MKEadmin/Cooling_Cities/Documents/07 Ontwerpen en materiaallijsten/Tekeningen en Schetsen/Hardware.png

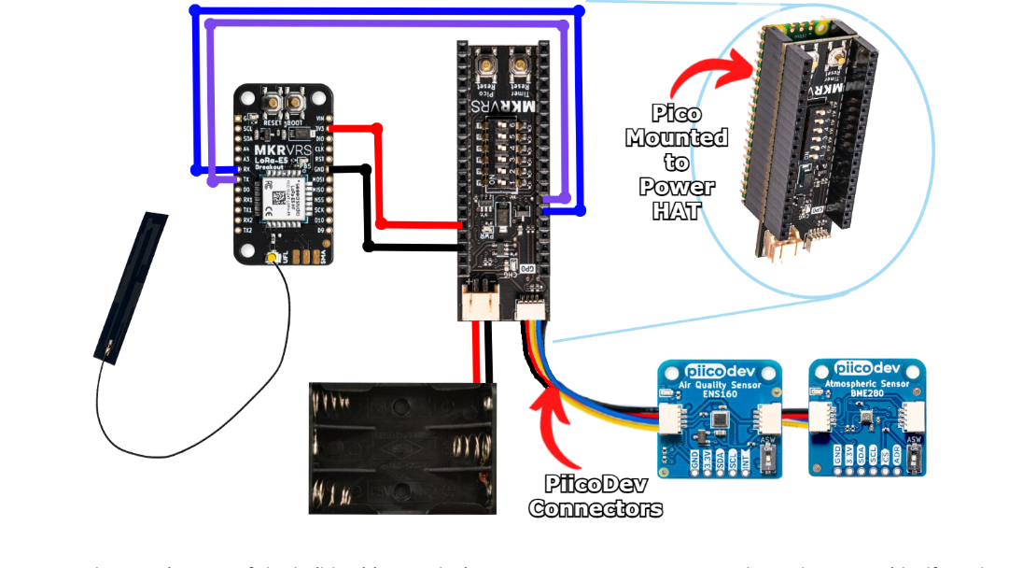
Documents/07 Ontwerpen en materiaallijsten/Tekeningen en Schetsen/Hardware.png
