MKEadmin/Cooling_Cities/Documents/07 Ontwerpen en materiaallijsten/Tekeningen en Schetsen/Systeem Schema.jpeg

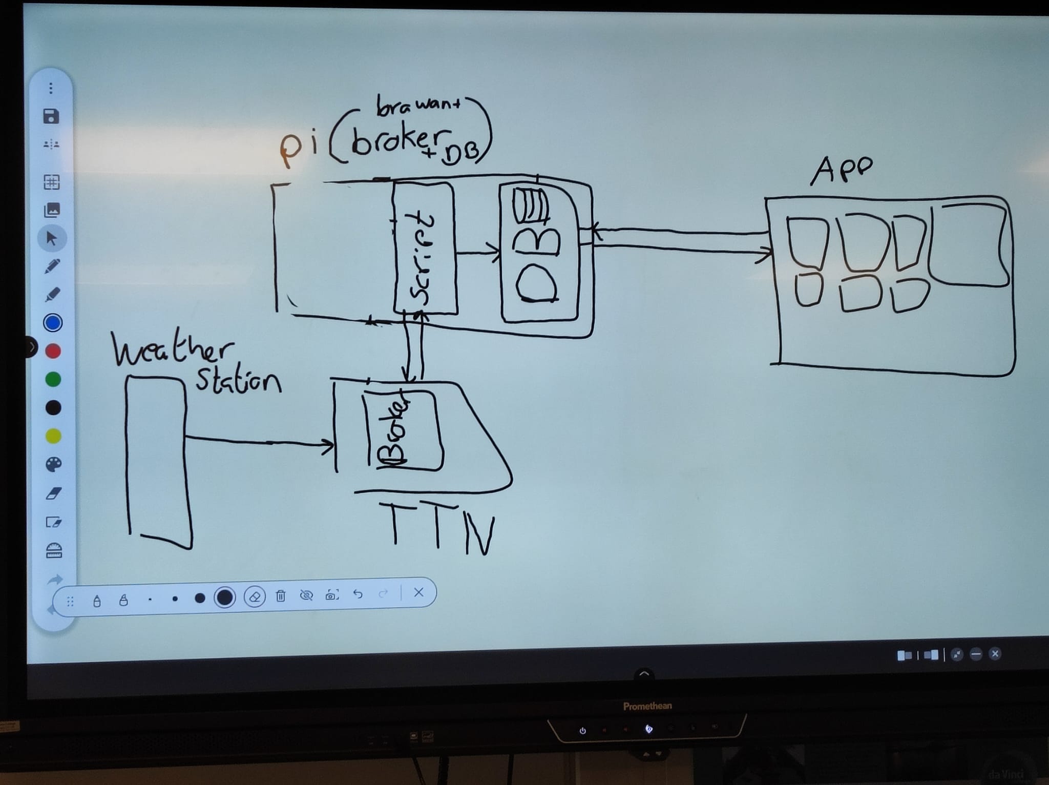
Documents/07 Ontwerpen en materiaallijsten/Tekeningen en Schetsen/Systeem Schema.jpeg
