MKEadmin/Cooling_Cities/Documents/02 Planningen/Organiseert mensen en middelen.docx

22-11-23
Fabian | LoRa-e5 module headers solderen | 0,12 uren
Fabian | Hulp bij installeren | 0,25 uren
Fabian | Pico W headers solderen | 0,13 uren
Fabian | Hulp LoRa transmissie | 0,75 uren
Fabian | Datacake & TTN -> mqtt | 2,00 uren
24-11-23
Fabian | TX-power error | 4,00 uren
