MKEadmin/Cooling_Cities/Documents/07 Ontwerpen en materiaallijsten/Tekeningen en Schetsen/Morfologisch_Overzicht.pdf

Cooling down the Cities | Route 1 Route 2 Route 3

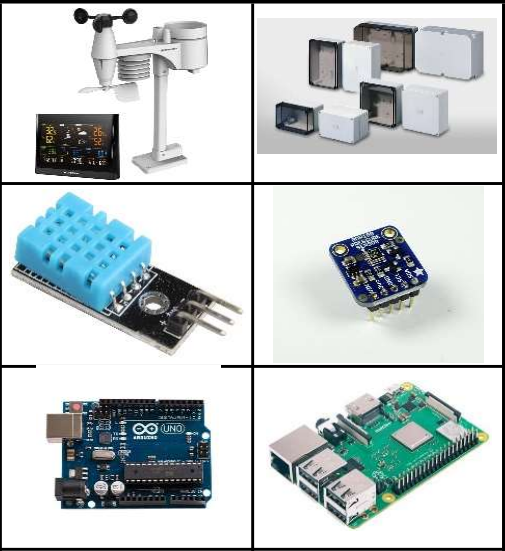
[picture p12: figure]
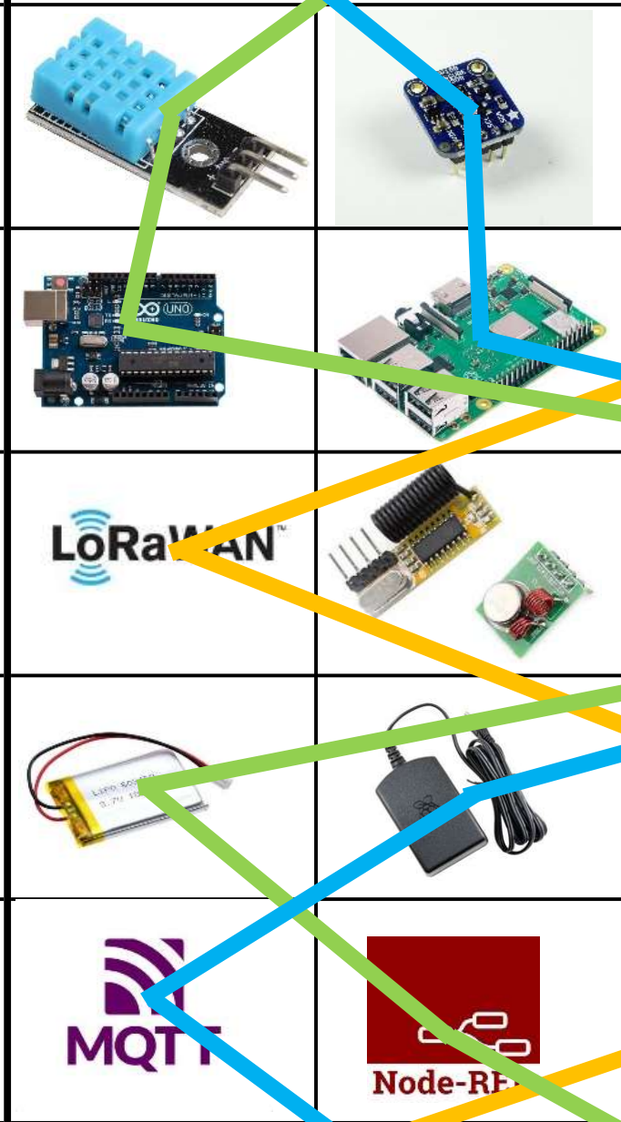
[picture p13: figure]

Behuizing

Sensoren

Microcontoller

Draadloze communicatie

Voeding

Gateway

Programmeringstaal
