MKEadmin/Cooling_Cities/Documents/07 Ontwerpen en materiaallijsten/Materiaallijst/Declaratie/PostNL inklaringskosten.jpg

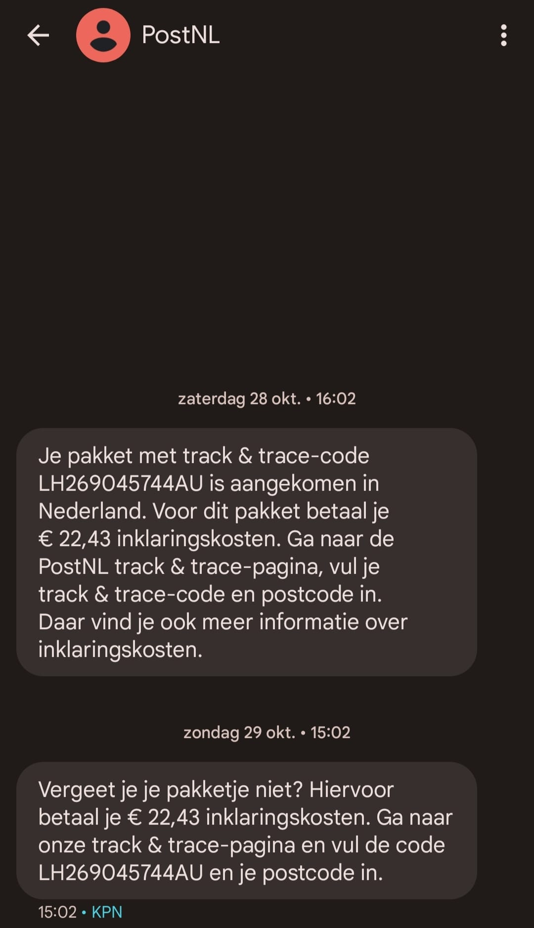
Documents/07 Ontwerpen en materiaallijsten/Materiaallijst/Declaratie/PostNL inklaringskosten.jpg
