MKEadmin/Cooling_Cities/Documents/07 Ontwerpen en materiaallijsten/Materiaallijst/Materiaallijst Weerstation.xlsx

Naam: | Mozes Hak
Datum: | 2023-10-04
Afdeling: | Smart Technology
Project: | Mackaton
Image | Product Name | Leverancier | Price | Aantal
 | Waterproof (Stevenson Screen) Case (https://www.conrad.nl/nl/p/tfa-dostmann-98-1114-02-beschermende-behuizing-2839716.html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) | Conrad | €13.99 | 1
 | Raspberry Pi Pico (with Soldered Female Headers) | Core electronics | €5.99 | 1
 | Makerverse LoRa-E5 Breakout | Core electronics | €20.60 | 1
 | 915MHz uFL antenna | Core electronics | €4.07 | 1
 | Makerverse Nano Power Timer HAT for Raspberry Pi Pico | Core electronics | €7.50 | 1
 | PiicoDev Air Quality Sensor ENS160 | Core electronics | €20.30 | 1
 | PiicoDev Atmospheric Sensor BME280 | Core electronics | €11.29 | 1
 | PiicoDev Cable Expansion Kit | Core electronics | €8.78 | 1
 | 3xAAA Battery Holder | Core electronics | €1.54 | 1
 | Jumper wires for breadboards | School | ... | 2
 | M3 Assorted Nylon Hardware Kit | School | ... | 1
 | Custom 3d printed part | School | ... | 2
