MKEadmin/Cooling_Cities/Documents/03 Kosten en urenregistratie/CdtC urenregistratie 17-01-2024.xlsx

Sheet: TOTAAL
Urenregistratie
PROJECTMAAM | Ontwikkel producten en systemen (B1-K1) |  |  |  | Voorbereiden (P1-K1) |  |  | Begeleiden productie (B1-K2)
 | Verzamelen van ontwerpgegevens (B1-K1-W1) | Werkt ontwerpen uit (B1-K1-W2) | Kiest materialen en onderdelen (B1-K1-W3) | Maakt een kostenberekening (B1-K1-W4) | Verzamelt en verwerkt productiegegevens (P1-K1-W1) | Maakt een tekeningenpakket (P1-K1-W2) | Organiseert mensen en middelen (P1-K1-W3) | Begeleidt werkproces (B1-K2-W1) | Bewaakt begroting (B1-K2-W2) | Voert kwaliteitscontroles uit (B1-K2-W3) | Levert werk op (B1-K2-W4) | Totaal
Mozes Hak | 14 | 30 | 6 | 2 | 5 | 13 | 1 | 9 | 3 | 24 | 15 | 122
student 02 | 0 | 0 | 0 | 0 | 0 | 0 | 0 | 0 | 0 | 0 | 0 | 0
student 03 | 0 | 0 | 0 | 0 | 0 | 0 | 0 | 0 | 0 | 0 | 0 | 0
student 04 | 0 | 0 | 0 | 0 | 0 | 0 | 0 | 0 | 0 | 0 | 0 | 0
student 05 | 0 | 0 | 0 | 0 | 0 | 0 | 0 | 0 | 0 | 0 | 0 | 0
student 06 | 0 | 0 | 0 | 0 | 0 | 0 | 0 | 0 | 0 | 0 | 0 | 0
Totaal | 14 | 30 | 6 | 2 | 5 | 13 | 1 | 9 | 3 | 24 | 15 | 122
Kostenregistratie
Materiaal kosten | €126.31
Opmerking. Zie tabblad kostregistratie voor de specificatie
Man uren | Uren | per uur | Totaal
Mozes Hak | 122 | €50.00 | €6100.00
Expert(F. Boshoven) | 7.5 | €75.00 | €562.50
 | Dagen | kosten | Totaal
Kantoor kosten | 15 | €150.00 | €2250.00
Werkplaats kosten | 2 | €125.00 | €250.00
Project totaal kosten | €9288.81

Sheet: Week 20 sep
 | Ontwikkel producten en systemen (B1-K1) |  |  |  | Voorbereiden (P1-K1) |  |  | Begeleiden productie (B1-K2)
 | Verzamelen van ontwerpgegevens (B1-K1-W1) | Werkt ontwerpen uit (B1-K1-W2) | Kiest materialen en onderdelen (B1-K1-W3) | Maakt een kostenberekening (B1-K1-W4) | Verzamelt en verwerkt productiegegevens (P1-K1-W1) | Maakt een tekeningenpakket (P1-K1-W2) | Organiseert mensen en middelen (P1-K1-W3) | Begeleidt werkproces (B1-K2-W1) | Bewaakt begroting (B1-K2-W2) | Voert kwaliteitscontroles uit (B1-K2-W3) | Levert werk op (B1-K2-W4)
Mozes Hak | 7
student 02
student 03
student 04
student 05
student 06

Sheet: Week 27 sep
 | Ontwikkel producten en systemen (B1-K1) |  |  |  | Voorbereiden (P1-K1) |  |  | Begeleiden productie (B1-K2)
 | Verzamelen van ontwerpgegevens (B1-K1-W1) | Werkt ontwerpen uit (B1-K1-W2) | Kiest materialen en onderdelen (B1-K1-W3) | Maakt een kostenberekening (B1-K1-W4) | Verzamelt en verwerkt productiegegevens (P1-K1-W1) | Maakt een tekeningenpakket (P1-K1-W2) | Organiseert mensen en middelen (P1-K1-W3) | Begeleidt werkproces (B1-K2-W1) | Bewaakt begroting (B1-K2-W2) | Voert kwaliteitscontroles uit (B1-K2-W3) | Levert werk op (B1-K2-W4)
Mozes Hak | 7
student 02
student 03
student 04
student 05
student 06

Sheet: Week 04 okt
 | Ontwikkel producten en systemen (B1-K1) |  |  |  | Voorbereiden (P1-K1) |  |  | Begeleiden productie (B1-K2)
 | Verzamelen van ontwerpgegevens (B1-K1-W1) | Werkt ontwerpen uit (B1-K1-W2) | Kiest materialen en onderdelen (B1-K1-W3) | Maakt een kostenberekening (B1-K1-W4) | Verzamelt en verwerkt productiegegevens (P1-K1-W1) | Maakt een tekeningenpakket (P1-K1-W2) | Organiseert mensen en middelen (P1-K1-W3) | Begeleidt werkproces (B1-K2-W1) | Bewaakt begroting (B1-K2-W2) | Voert kwaliteitscontroles uit (B1-K2-W3) | Levert werk op (B1-K2-W4)
Mozes Hak |  | 7
student 02
student 03
student 04
student 05
student 06

Sheet: Week 11 okt
 | Ontwikkel producten en systemen (B1-K1) |  |  |  | Voorbereiden (P1-K1) |  |  | Begeleiden productie (B1-K2)
 | Verzamelen van ontwerpgegevens (B1-K1-W1) | Werkt ontwerpen uit (B1-K1-W2) | Kiest materialen en onderdelen (B1-K1-W3) | Maakt een kostenberekening (B1-K1-W4) | Verzamelt en verwerkt productiegegevens (P1-K1-W1) | Maakt een tekeningenpakket (P1-K1-W2) | Organiseert mensen en middelen (P1-K1-W3) | Begeleidt werkproces (B1-K2-W1) | Bewaakt begroting (B1-K2-W2) | Voert kwaliteitscontroles uit (B1-K2-W3) | Levert werk op (B1-K2-W4)
Mozes Hak |  | 7
student 02
student 03
student 04
student 05
student 06

Sheet: Week 25 okt
 | Ontwikkel producten en systemen (B1-K1) |  |  |  | Voorbereiden (P1-K1) |  |  | Begeleiden productie (B1-K2)
 | Verzamelen van ontwerpgegevens (B1-K1-W1) | Werkt ontwerpen uit (B1-K1-W2) | Kiest materialen en onderdelen (B1-K1-W3) | Maakt een kostenberekening (B1-K1-W4) | Verzamelt en verwerkt productiegegevens (P1-K1-W1) | Maakt een tekeningenpakket (P1-K1-W2) | Organiseert mensen en middelen (P1-K1-W3) | Begeleidt werkproces (B1-K2-W1) | Bewaakt begroting (B1-K2-W2) | Voert kwaliteitscontroles uit (B1-K2-W3) | Levert werk op (B1-K2-W4)
Mozes Hak |  | 6 |  |  |  |  |  |  | 1
student 02
student 03
student 04
student 05
student 06

Sheet: Week 01 nov
 | Ontwikkel producten en systemen (B1-K1) |  |  |  | Voorbereiden (P1-K1) |  |  | Begeleiden productie (B1-K2)
 | Verzamelen van ontwerpgegevens (B1-K1-W1) | Werkt ontwerpen uit (B1-K1-W2) | Kiest materialen en onderdelen (B1-K1-W3) | Maakt een kostenberekening (B1-K1-W4) | Verzamelt en verwerkt productiegegevens (P1-K1-W1) | Maakt een tekeningenpakket (P1-K1-W2) | Organiseert mensen en middelen (P1-K1-W3) | Begeleidt werkproces (B1-K2-W1) | Bewaakt begroting (B1-K2-W2) | Voert kwaliteitscontroles uit (B1-K2-W3) | Levert werk op (B1-K2-W4)
Mozes Hak
student 02
student 03
student 04
student 05
student 06

Sheet: Week 08 nov
 | Ontwikkel producten en systemen (B1-K1) |  |  |  | Voorbereiden (P1-K1) |  |  | Begeleiden productie (B1-K2)
 | Verzamelen van ontwerpgegevens (B1-K1-W1) | Werkt ontwerpen uit (B1-K1-W2) | Kiest materialen en onderdelen (B1-K1-W3) | Maakt een kostenberekening (B1-K1-W4) | Verzamelt en verwerkt productiegegevens (P1-K1-W1) | Maakt een tekeningenpakket (P1-K1-W2) | Organiseert mensen en middelen (P1-K1-W3) | Begeleidt werkproces (B1-K2-W1) | Bewaakt begroting (B1-K2-W2) | Voert kwaliteitscontroles uit (B1-K2-W3) | Levert werk op (B1-K2-W4)
Mozes Hak |  | 2 |  |  |  |  |  |  | 2
student 02
student 03
student 04
student 05
student 06

Sheet: Week 15 nov
 | Ontwikkel producten en systemen (B1-K1) |  |  |  | Voorbereiden (P1-K1) |  |  | Begeleiden productie (B1-K2)
 | Verzamelen van ontwerpgegevens (B1-K1-W1) | Werkt ontwerpen uit (B1-K1-W2) | Kiest materialen en onderdelen (B1-K1-W3) | Maakt een kostenberekening (B1-K1-W4) | Verzamelt en verwerkt productiegegevens (P1-K1-W1) | Maakt een tekeningenpakket (P1-K1-W2) | Organiseert mensen en middelen (P1-K1-W3) | Begeleidt werkproces (B1-K2-W1) | Bewaakt begroting (B1-K2-W2) | Voert kwaliteitscontroles uit (B1-K2-W3) | Levert werk op (B1-K2-W4)
Mozes Hak |  |  |  |  |  | 6
student 02
student 03
student 04
student 05
student 06

Sheet: Week 22 nov
 | Ontwikkel producten en systemen (B1-K1) |  |  |  | Voorbereiden (P1-K1) |  |  | Begeleiden productie (B1-K2)
 | Verzamelen van ontwerpgegevens (B1-K1-W1) | Werkt ontwerpen uit (B1-K1-W2) | Kiest materialen en onderdelen (B1-K1-W3) | Maakt een kostenberekening (B1-K1-W4) | Verzamelt en verwerkt productiegegevens (P1-K1-W1) | Maakt een tekeningenpakket (P1-K1-W2) | Organiseert mensen en middelen (P1-K1-W3) | Begeleidt werkproces (B1-K2-W1) | Bewaakt begroting (B1-K2-W2) | Voert kwaliteitscontroles uit (B1-K2-W3) | Levert werk op (B1-K2-W4)
Mozes Hak |  | 3 |  |  |  | 4 |  |  |  | 4
student 02
student 03
student 04
student 05
student 06

Sheet: Week 29 nov
 | Ontwikkel producten en systemen (B1-K1) |  |  |  | Voorbereiden (P1-K1) |  |  | Begeleiden productie (B1-K2)
 | Verzamelen van ontwerpgegevens (B1-K1-W1) | Werkt ontwerpen uit (B1-K1-W2) | Kiest materialen en onderdelen (B1-K1-W3) | Maakt een kostenberekening (B1-K1-W4) | Verzamelt en verwerkt productiegegevens (P1-K1-W1) | Maakt een tekeningenpakket (P1-K1-W2) | Organiseert mensen en middelen (P1-K1-W3) | Begeleidt werkproces (B1-K2-W1) | Bewaakt begroting (B1-K2-W2) | Voert kwaliteitscontroles uit (B1-K2-W3) | Levert werk op (B1-K2-W4)
Mozes Hak |  |  |  |  |  |  |  |  |  | 7
student 02
student 03
student 04
student 05
student 06

Sheet: Week 06 dec
 | Ontwikkel producten en systemen (B1-K1) |  |  |  | Voorbereiden (P1-K1) |  |  | Begeleiden productie (B1-K2)
 | Verzamelen van ontwerpgegevens (B1-K1-W1) | Werkt ontwerpen uit (B1-K1-W2) | Kiest materialen en onderdelen (B1-K1-W3) | Maakt een kostenberekening (B1-K1-W4) | Verzamelt en verwerkt productiegegevens (P1-K1-W1) | Maakt een tekeningenpakket (P1-K1-W2) | Organiseert mensen en middelen (P1-K1-W3) | Begeleidt werkproces (B1-K2-W1) | Bewaakt begroting (B1-K2-W2) | Voert kwaliteitscontroles uit (B1-K2-W3) | Levert werk op (B1-K2-W4)
Mozes Hak |  |  |  |  |  |  |  |  |  | 7
student 02
student 03
student 04
student 05
student 06

Sheet: Week 13 dec
 | Ontwikkel producten en systemen (B1-K1) |  |  |  | Voorbereiden (P1-K1) |  |  | Begeleiden productie (B1-K2)
 | Verzamelen van ontwerpgegevens (B1-K1-W1) | Werkt ontwerpen uit (B1-K1-W2) | Kiest materialen en onderdelen (B1-K1-W3) | Maakt een kostenberekening (B1-K1-W4) | Verzamelt en verwerkt productiegegevens (P1-K1-W1) | Maakt een tekeningenpakket (P1-K1-W2) | Organiseert mensen en middelen (P1-K1-W3) | Begeleidt werkproces (B1-K2-W1) | Bewaakt begroting (B1-K2-W2) | Voert kwaliteitscontroles uit (B1-K2-W3) | Levert werk op (B1-K2-W4)
Mozes Hak |  |  |  |  |  |  |  | 6 |  | 1
student 02
student 03
student 04
student 05
student 06

Sheet: Week 20 dec
 | Ontwikkel producten en systemen (B1-K1) |  |  |  | Voorbereiden (P1-K1) |  |  | Begeleiden productie (B1-K2)
 | Verzamelen van ontwerpgegevens (B1-K1-W1) | Werkt ontwerpen uit (B1-K1-W2) | Kiest materialen en onderdelen (B1-K1-W3) | Maakt een kostenberekening (B1-K1-W4) | Verzamelt en verwerkt productiegegevens (P1-K1-W1) | Maakt een tekeningenpakket (P1-K1-W2) | Organiseert mensen en middelen (P1-K1-W3) | Begeleidt werkproces (B1-K2-W1) | Bewaakt begroting (B1-K2-W2) | Voert kwaliteitscontroles uit (B1-K2-W3) | Levert werk op (B1-K2-W4)
Mozes Hak |  | 4 | 3
student 02
student 03
student 04
student 05
student 06

Sheet: Week 10 jan
 | Ontwikkel producten en systemen (B1-K1) |  |  |  | Voorbereiden (P1-K1) |  |  | Begeleiden productie (B1-K2)
 | Verzamelen van ontwerpgegevens (B1-K1-W1) | Werkt ontwerpen uit (B1-K1-W2) | Kiest materialen en onderdelen (B1-K1-W3) | Maakt een kostenberekening (B1-K1-W4) | Verzamelt en verwerkt productiegegevens (P1-K1-W1) | Maakt een tekeningenpakket (P1-K1-W2) | Organiseert mensen en middelen (P1-K1-W3) | Begeleidt werkproces (B1-K2-W1) | Bewaakt begroting (B1-K2-W2) | Voert kwaliteitscontroles uit (B1-K2-W3) | Levert werk op (B1-K2-W4)
Mozes Hak |  |  |  |  |  |  |  |  |  |  | 7
student 02
student 03
student 04
student 05
student 06

Sheet: Week 17 jan
 | Ontwikkel producten en systemen (B1-K1) |  |  |  | Voorbereiden (P1-K1) |  |  | Begeleiden productie (B1-K2)
 | Verzamelen van ontwerpgegevens (B1-K1-W1) | Werkt ontwerpen uit (B1-K1-W2) | Kiest materialen en onderdelen (B1-K1-W3) | Maakt een kostenberekening (B1-K1-W4) | Verzamelt en verwerkt productiegegevens (P1-K1-W1) | Maakt een tekeningenpakket (P1-K1-W2) | Organiseert mensen en middelen (P1-K1-W3) | Begeleidt werkproces (B1-K2-W1) | Bewaakt begroting (B1-K2-W2) | Voert kwaliteitscontroles uit (B1-K2-W3) | Levert werk op (B1-K2-W4)
Mozes Hak |  |  |  |  |  |  |  |  |  |  | 7
student 02
student 03
student 04
student 05
student 06

Sheet: Week 24 jan
 | Ontwikkel producten en systemen (B1-K1) |  |  |  | Voorbereiden (P1-K1) |  |  | Begeleiden productie (B1-K2)
 | Verzamelen van ontwerpgegevens (B1-K1-W1) | Werkt ontwerpen uit (B1-K1-W2) | Kiest materialen en onderdelen (B1-K1-W3) | Maakt een kostenberekening (B1-K1-W4) | Verzamelt en verwerkt productiegegevens (P1-K1-W1) | Maakt een tekeningenpakket (P1-K1-W2) | Organiseert mensen en middelen (P1-K1-W3) | Begeleidt werkproces (B1-K2-W1) | Bewaakt begroting (B1-K2-W2) | Voert kwaliteitscontroles uit (B1-K2-W3) | Levert werk op (B1-K2-W4)
Mozes Hak |  |  | 2 |  |  |  |  |  |  | 5
student 02
student 03
student 04
student 05
student 06

Sheet: Week 31 jan
 | Ontwikkel producten en systemen (B1-K1) |  |  |  | Voorbereiden (P1-K1) |  |  | Begeleiden productie (B1-K2)
 | Verzamelen van ontwerpgegevens (B1-K1-W1) | Werkt ontwerpen uit (B1-K1-W2) | Kiest materialen en onderdelen (B1-K1-W3) | Maakt een kostenberekening (B1-K1-W4) | Verzamelt en verwerkt productiegegevens (P1-K1-W1) | Maakt een tekeningenpakket (P1-K1-W2) | Organiseert mensen en middelen (P1-K1-W3) | Begeleidt werkproces (B1-K2-W1) | Bewaakt begroting (B1-K2-W2) | Voert kwaliteitscontroles uit (B1-K2-W3) | Levert werk op (B1-K2-W4)
Mozes Hak |  | 1 | 1 | 2 | 5 | 3 | 1 | 3 |  |  | 1
student 02
student 03
student 04
student 05
student 06

Sheet: Kostenregistratie
datum | leverancier | factuurnummer | bedrag | aus dollar
2023-10-04 | Conrad | 2839716 | €14.99
2023-10-05 | Core Electronics | CE08554 | €5.70 | $9.50
2023-10-05 | Core Electronics | CE09196 | €19.36 | $32.27
2023-10-05 | Core Electronics | CE09458 | €3.68 | $6.14
2023-10-05 | Core Electronics | CE08492 | €6.87 | $11.45
2023-10-05 | Core Electronics | CE08560 | €18.38 | $30.64
2023-10-05 | Core Electronics | CE07503 | €10.23 | $17.05
2023-10-05 | Core Electronics | CE09146 | €8.12 | $13.53
2023-10-05 | Core Electronics | FIT0626 | €1.42 | $2.36
2023-10-05 | Core Electronics | CE07759 | €0.59 | $0.98
2023-10-05 | Core Electronics | CE08703 | €5.40 | $9.00
2023-10-05 | Core Electronics | Shipping & Handling | €9.14 | $15.23
2023-10-29 | Post-NL | Inklaringskosten | €22.43
 |  | TOTAAL | €126.31
