MKEadmin/Cooling_Cities/Documents/07 Ontwerpen en materiaallijsten/Materiaallijst/Gegevens/Bestelbon Techniek en Media 2022-23.xlsx

Naam aanvrager: | Mozes Hak
Aanvraagdatum: | 2023-10-04
Afdeling: | Smart Technology
Project: | Mackaton
Bestelnummer: | Artikelnaam of link | Leverancier: | Aantal:
2839716 | Waterproof (Stevenson Screen) Case (https://www.conrad.nl/nl/p/tfa-dostmann-98-1114-02-beschermende-behuizing-2839716.html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) | Conrad | 1
 | https://www.123inkt.nl/
 | https://www.123-3d.nl/
 | https://www.amtc.eu/
 | https://www.bol.com/nl/
 | https://www.conrad.nl/
 | https://www.dcvakkleding.nl/
 | https://www.dch.nl/
 | https://www.eurofysica.nl/
 | https://nl.farnell.com/
 | https://www.festo.com/nl/nl/
 | https://www.hackerstore.nl/
 | https://www.hbm-machines.com/
 | https://www.itsmenederland.nl/itsme/nl/EUR/
 | https://www.jongeneel.nl/
 | https://www.luijtenvvz.nl/home
 | https://www.manutan.nl/nl/mnl
 | https://www.mastermate.nl/
 | https://www.opitec.nl/
 | https://www.rcracingtwente.nl/
 | https://new.siemens.com/nl/nl.html
 | https://www.stabiplan.com/nl-nl
 | https://www.tech-specialist.com/
 | https://www.technischeunie.nl/
 | https://www.troteclaser.com/nl/
 | https://www.ijzerwinkel.nl/
 | https://vndsignmakers.nl/
