MKEadmin/Cooling_Cities/Tekeningenpakket/CAD/LoRa Assembly 3D Printed Mount .stl

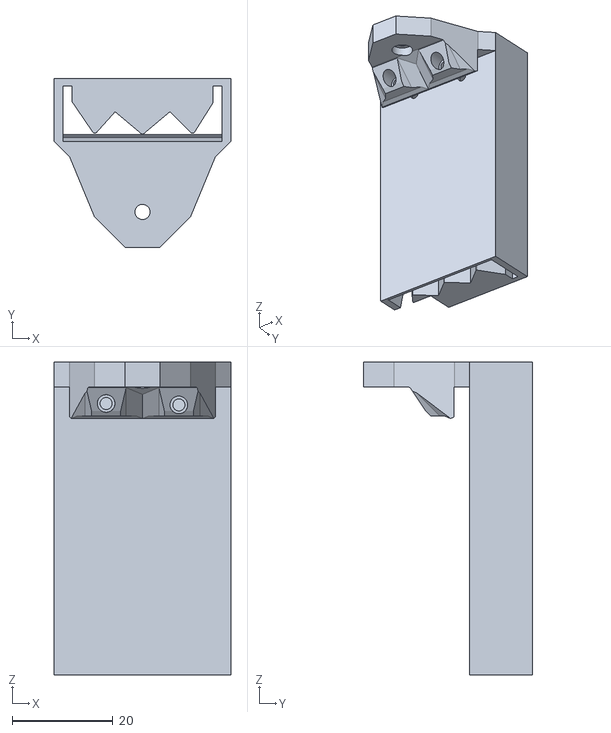
[picture p17: CAD file, 2024-06-12]
Tekeningenpakket/CAD/LoRa Assembly 3D Printed Mount .stl
35.0 x 33.4 x 62.0
