MKEadmin/Cooling_Cities/Tekeningenpakket/CAD/LoRa Assembly Laser Cut Mount STL.stl

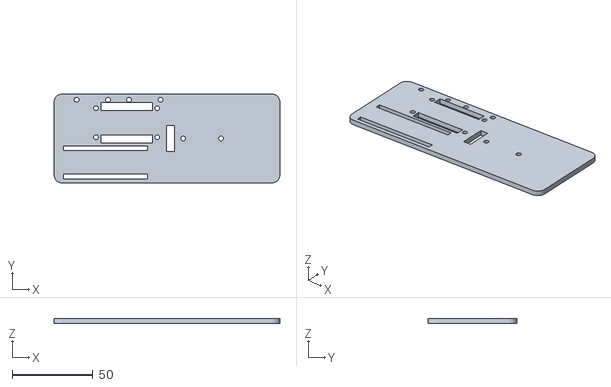
[picture p18: CAD file, 2024-06-12]
Tekeningenpakket/CAD/LoRa Assembly Laser Cut Mount STL.stl
140.0 x 55.0 x 3.00
