MKEadmin/Cooling_Cities/Documents/07 Ontwerpen en materiaallijsten/Materiaallijst/Declaratie/Order core eclectronics.pdf

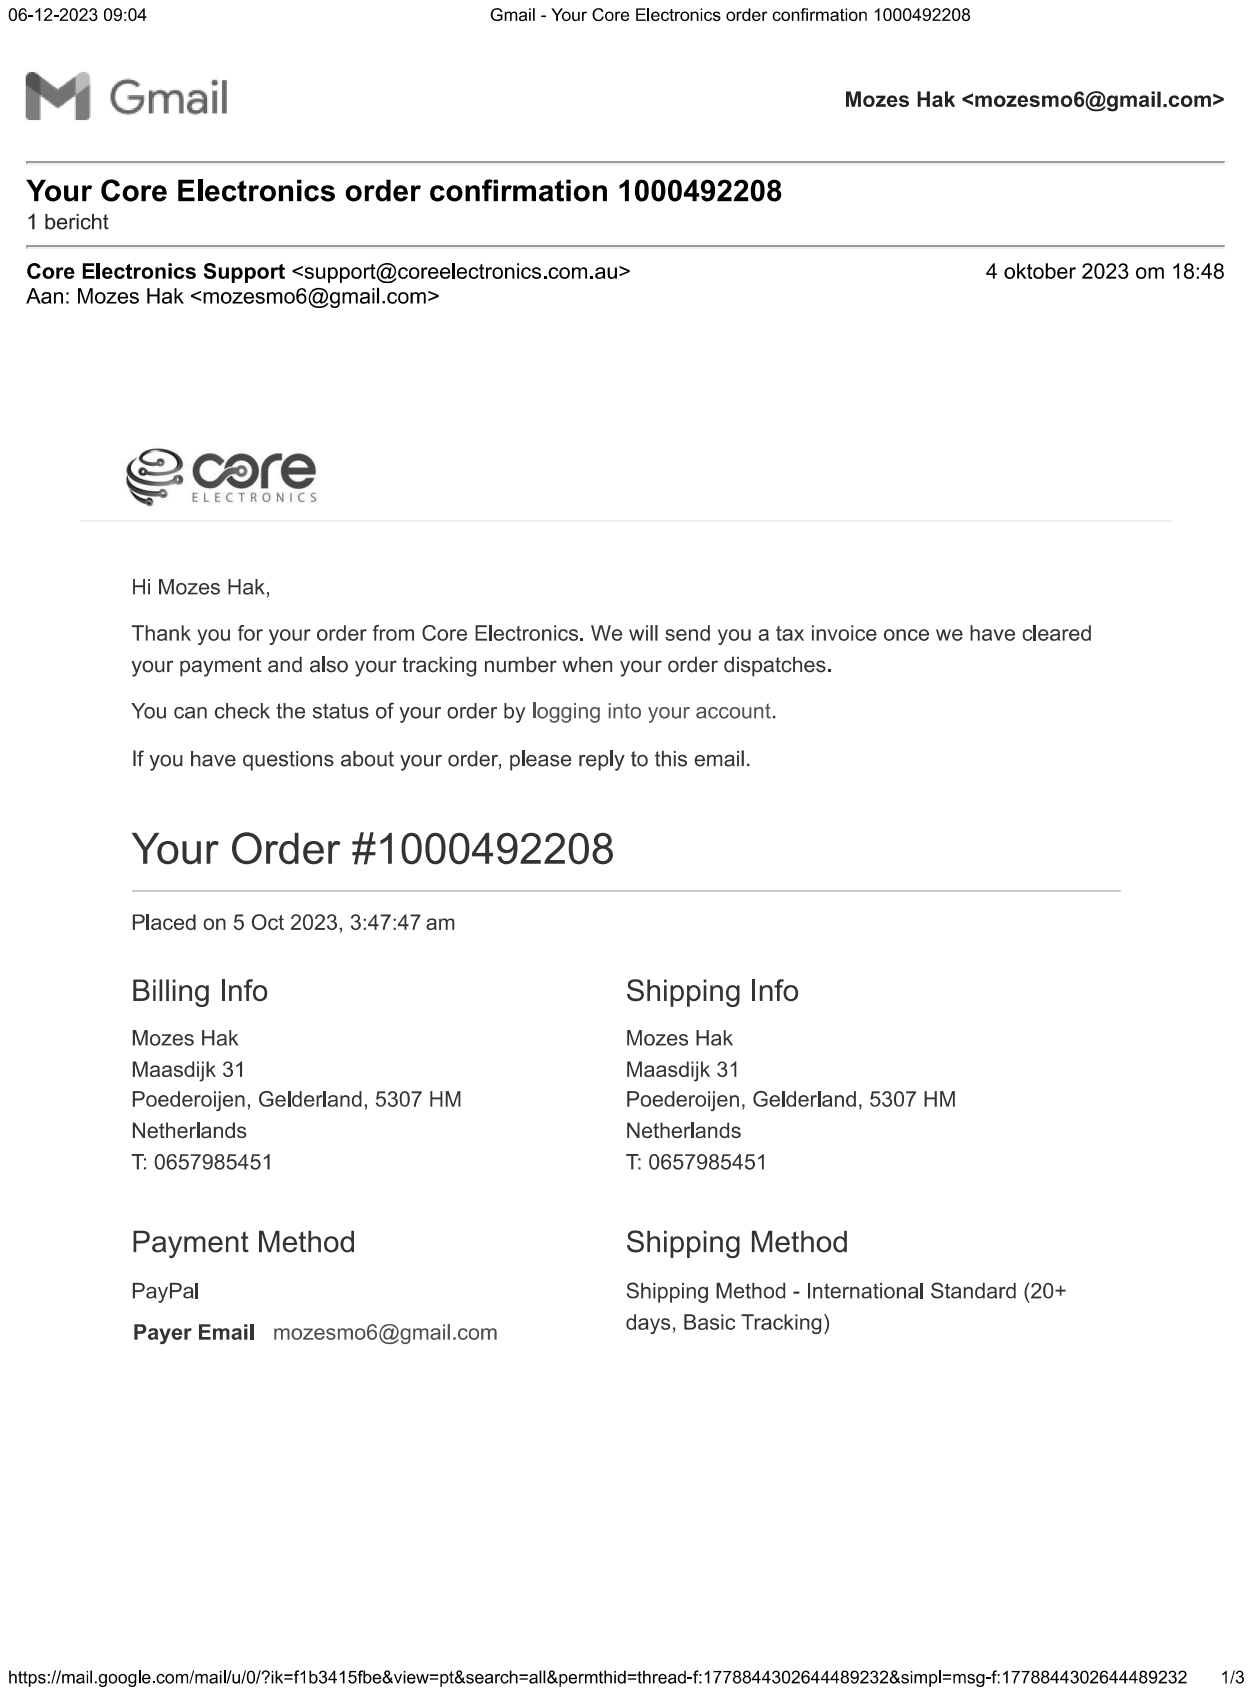
[picture p22: page 1]

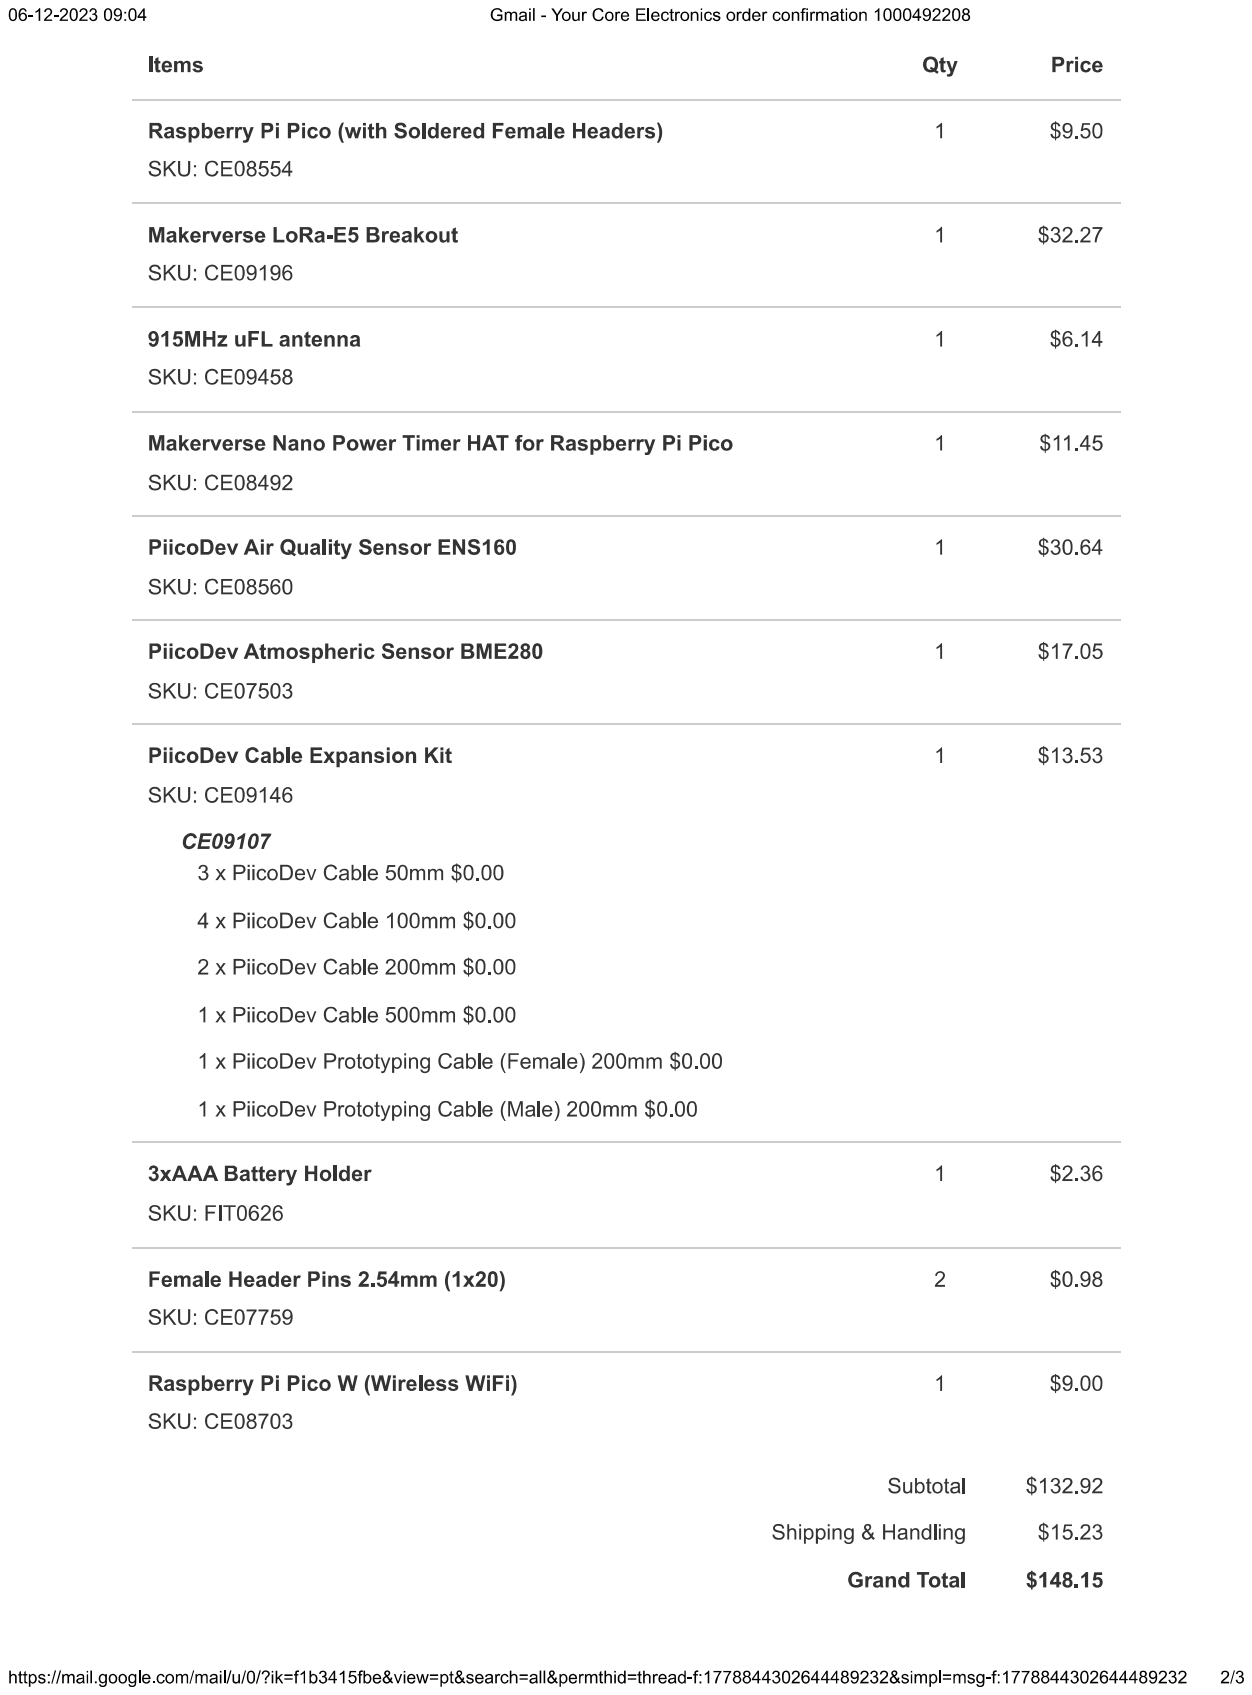
[picture p23: page 2]

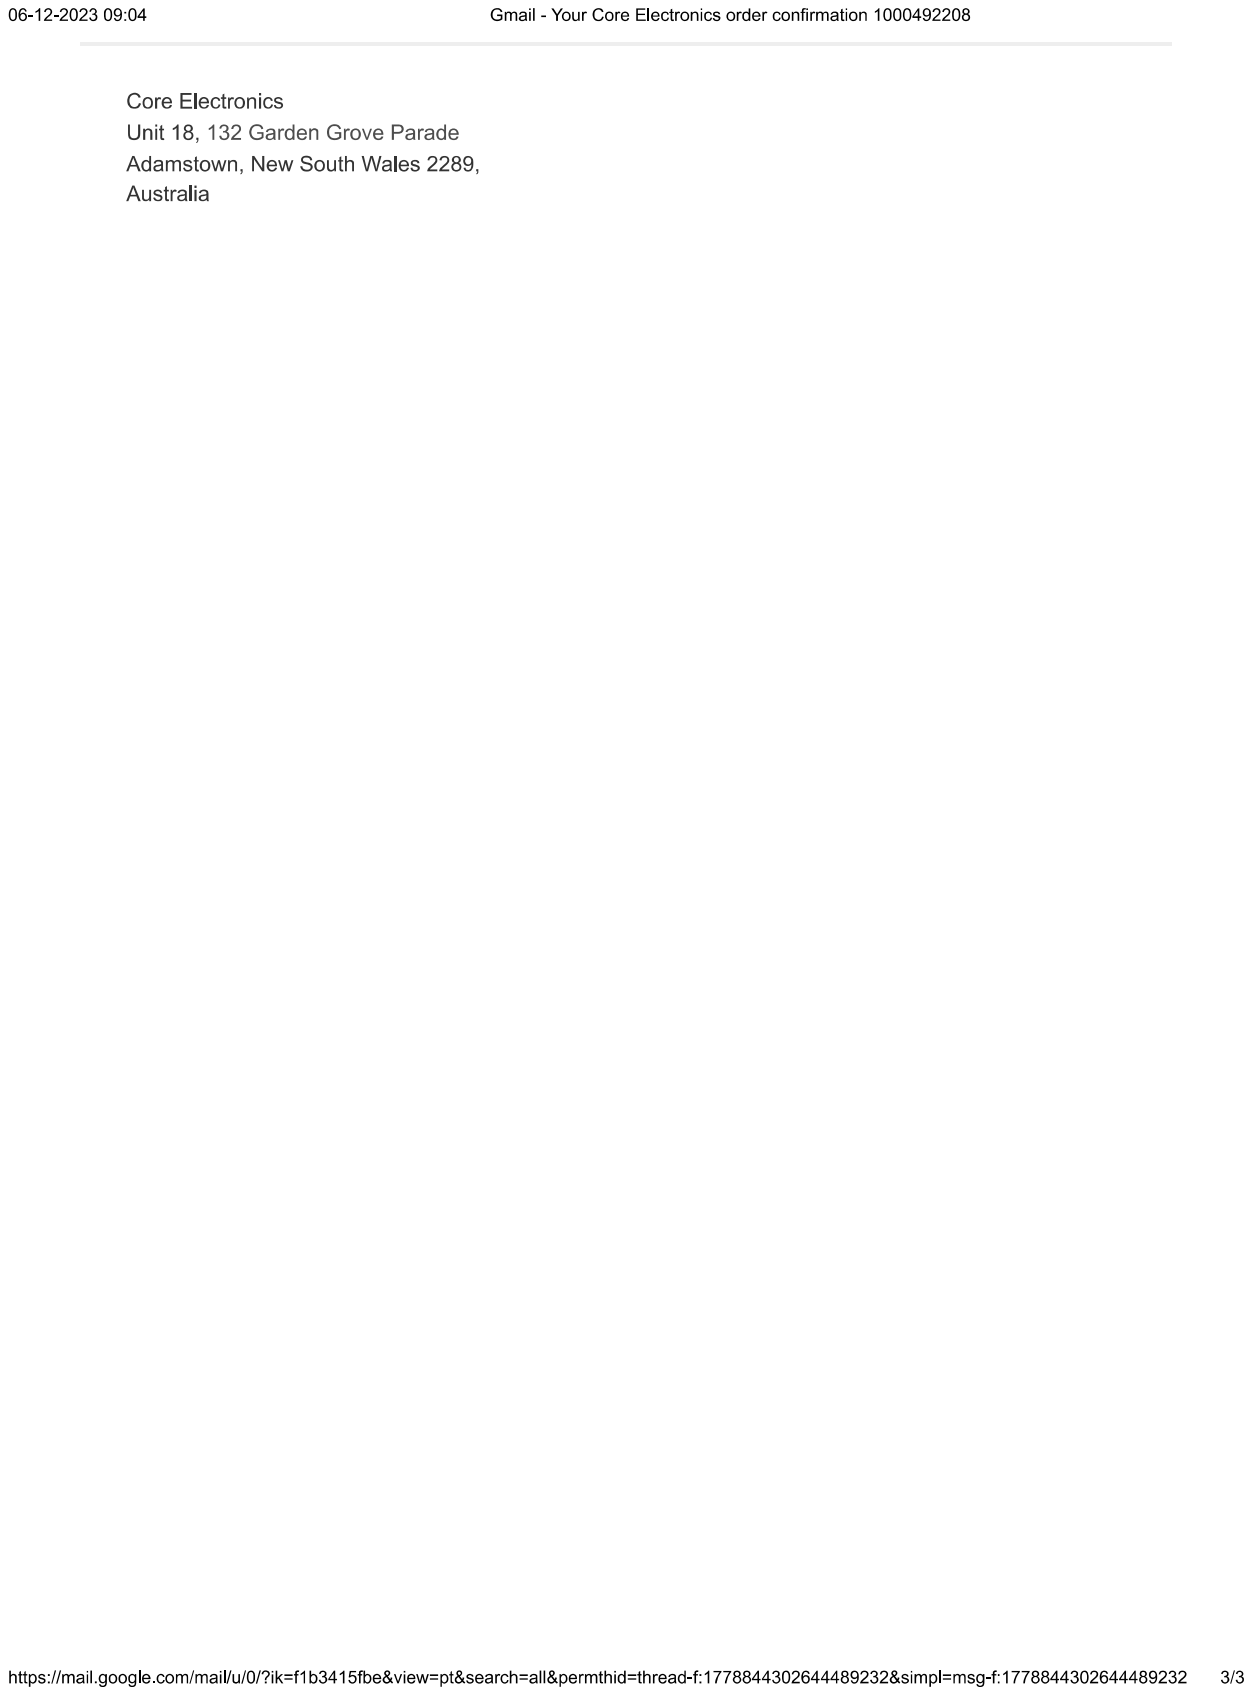
[picture p24: page 3]
