MKEadmin/Cooling_Cities/Code/Flowchart main.py code.pdf

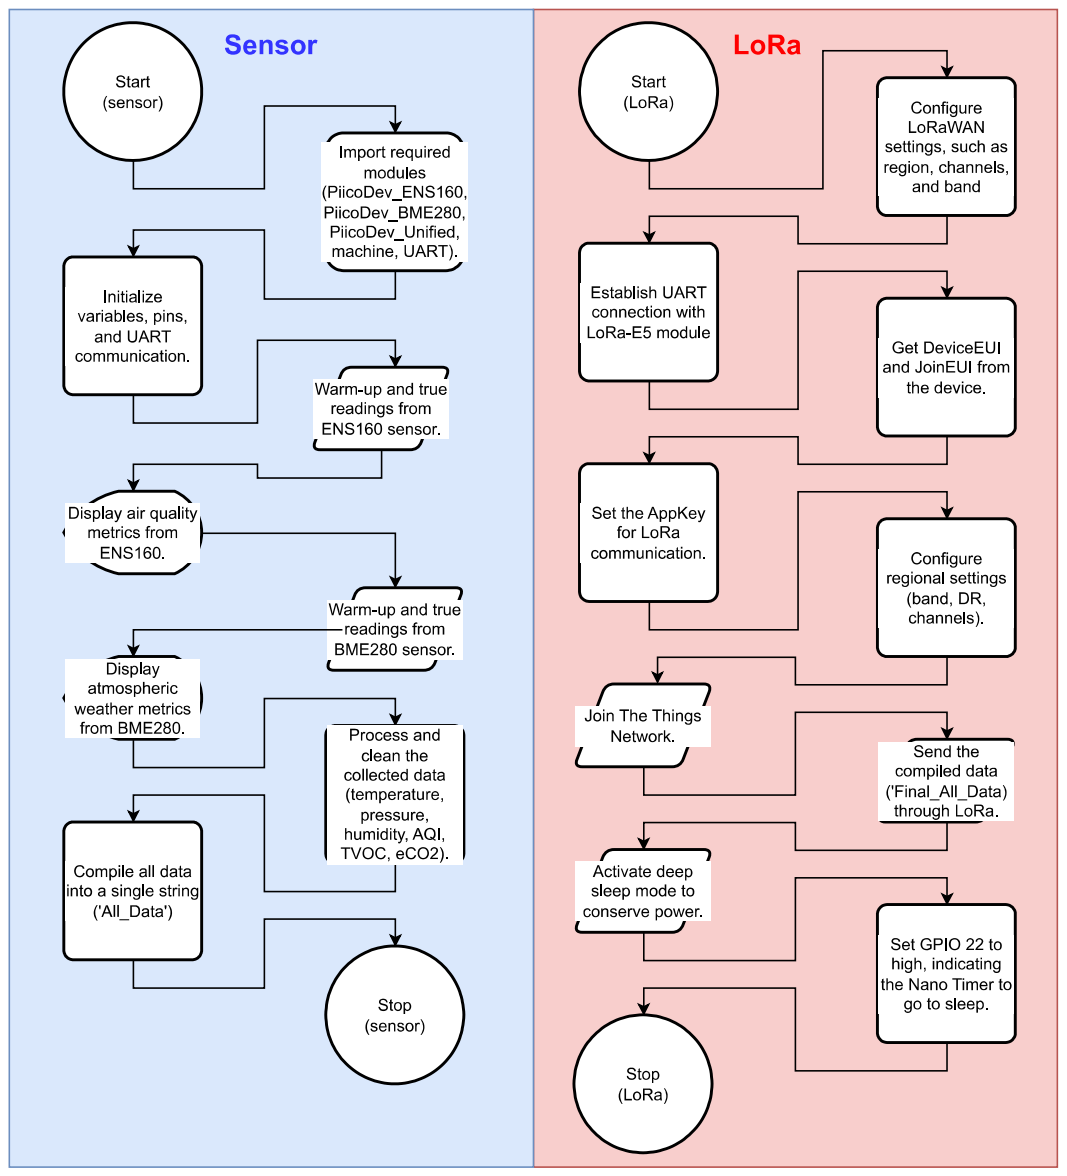
[picture p25: page 1]
