MKEadmin/Cooling_Cities/Documents/07 Ontwerpen en materiaallijsten/Tekeningen en Schetsen/Functieboom.pdf

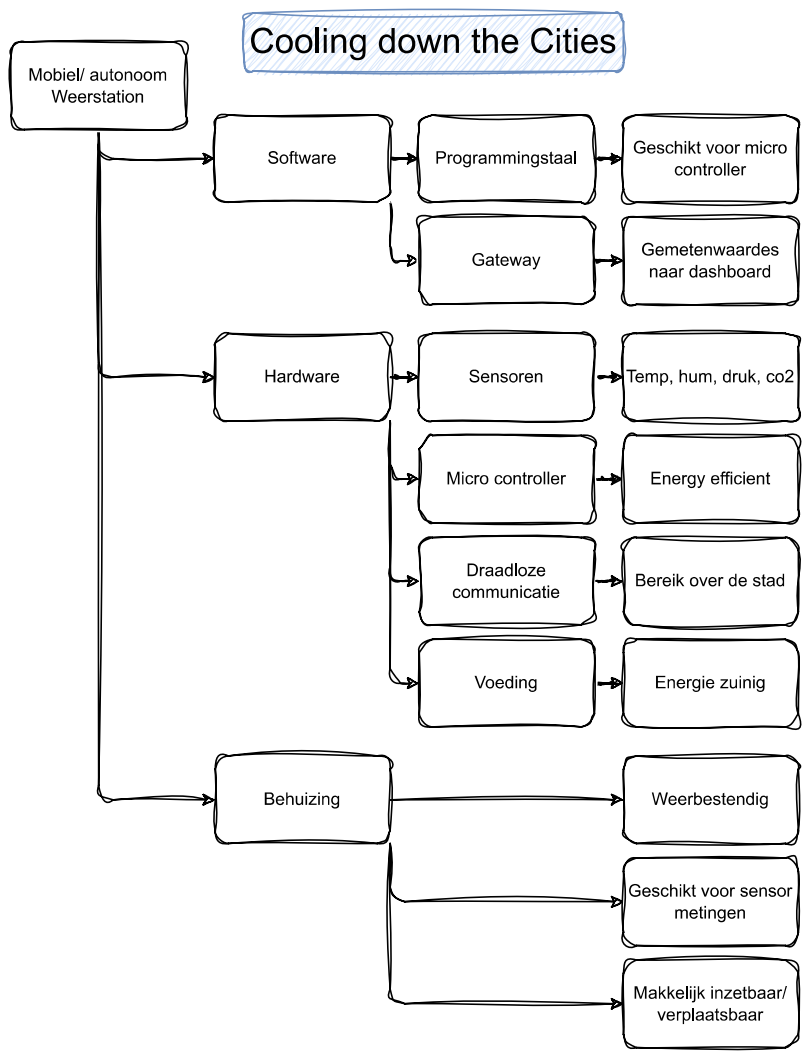
[picture p26: page 1]
