MKEadmin/Cooling_Cities/(commit log)

2024-06-12 initial version
    [Bestelbon Techniek en Media 2022-23.xlsx, CdtC urenregistratie 17-01-2024.xlsx, Checklist kwaliteitscontrole.xlsx, Declaratieformulier IB47 betalingen 20151 (3).xlsx, LoRa Assembly 3D Printed Mount .stl, LoRa Assembly Laser Cut Mount STL.stl, Materiaallijst Weerstation.xlsx]
2024-10-01 update files for stage 2
